XtromAI/Airsoft-Display/docs/hardware/datasheets/README.md

# Datasheet Drop Folder

This directory is reserved for third-party datasheets, reference manuals, or vendor utilities that should **not** be committed to the public repository. The files you place here are ignored by Git so you can keep local copies without redistributing copyrighted material.

## Recommended Downloads

| Component / Resource | Official Source |
| --- | --- |
| Raspberry Pi Pico Datasheet | https://datasheets.raspberrypi.com/pico/pico-datasheet.pdf |
| Getting Started with Raspberry Pi Pico | https://datasheets.raspberrypi.com/pico/getting-started-with-pico.pdf |
| Raspberry Pi Pico Pinout (PNG) | https://datasheets.raspberrypi.com/pico/pico-pinout.png |
| Raspberry Pi "flash nuke" UF2 | https://datasheets.raspberrypi.com/soft/pico-bootrom/flash_nuke.uf2 |
| SH1107 OLED Controller Datasheet | https://www.displayfuture.com/Display/datasheet/controller/SH1107.pdf |
| ST L7805CV Regulator Datasheet | https://www.st.com/resource/en/datasheet/l7805.pdf |

Place any downloaded copies directly in this folder for your own reference. If new documentation is required, update this table instead of adding the actual files to version control.
