XtromAI/Airsoft-Display/docs/hardware/Airsoft Display circuit _251127_172856_1.jpg

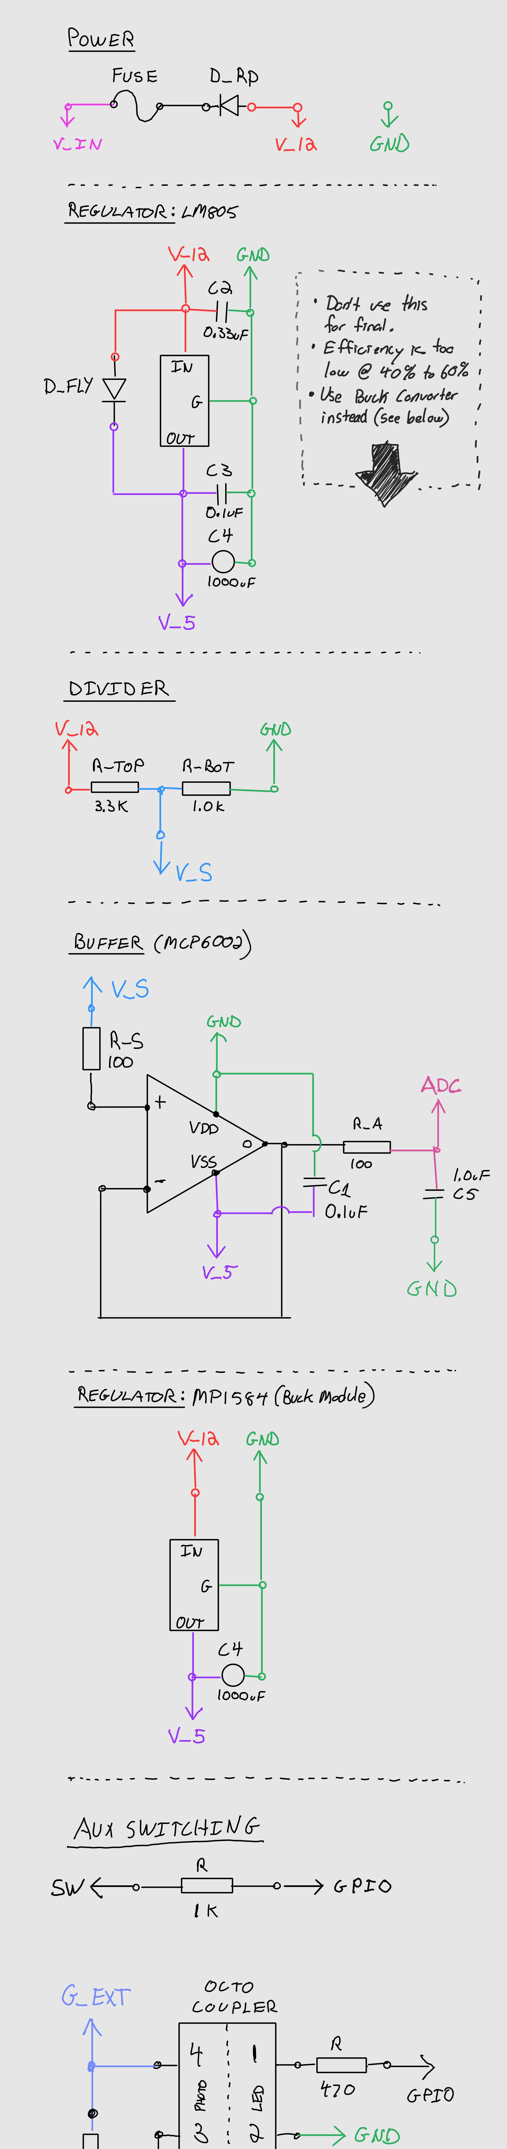
docs/hardware/Airsoft Display circuit _251127_172856_1.jpg
