XtromAI/Airsoft-Display/docs/hardware/airsoft-display-schematic.png

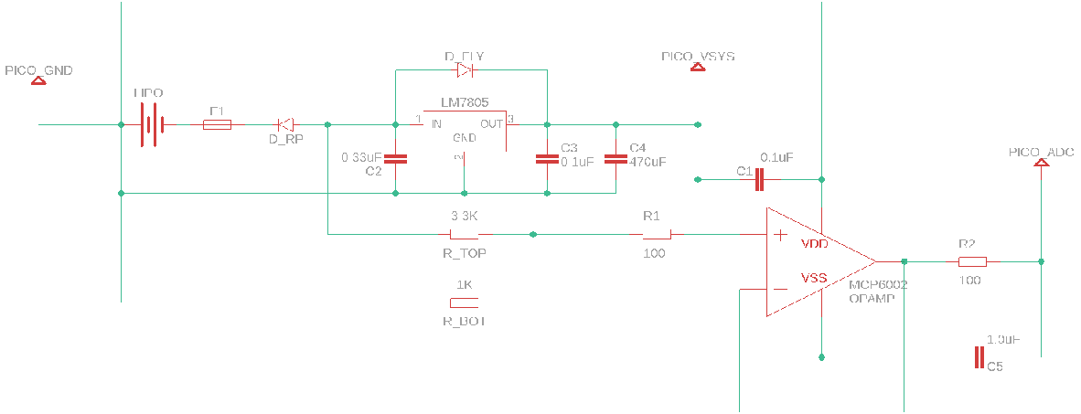
docs/hardware/airsoft-display-schematic.png
