XtromAI/Airsoft-Display/tools/data/capture_2025-11-11-22-56-46_a/capture_00000.png

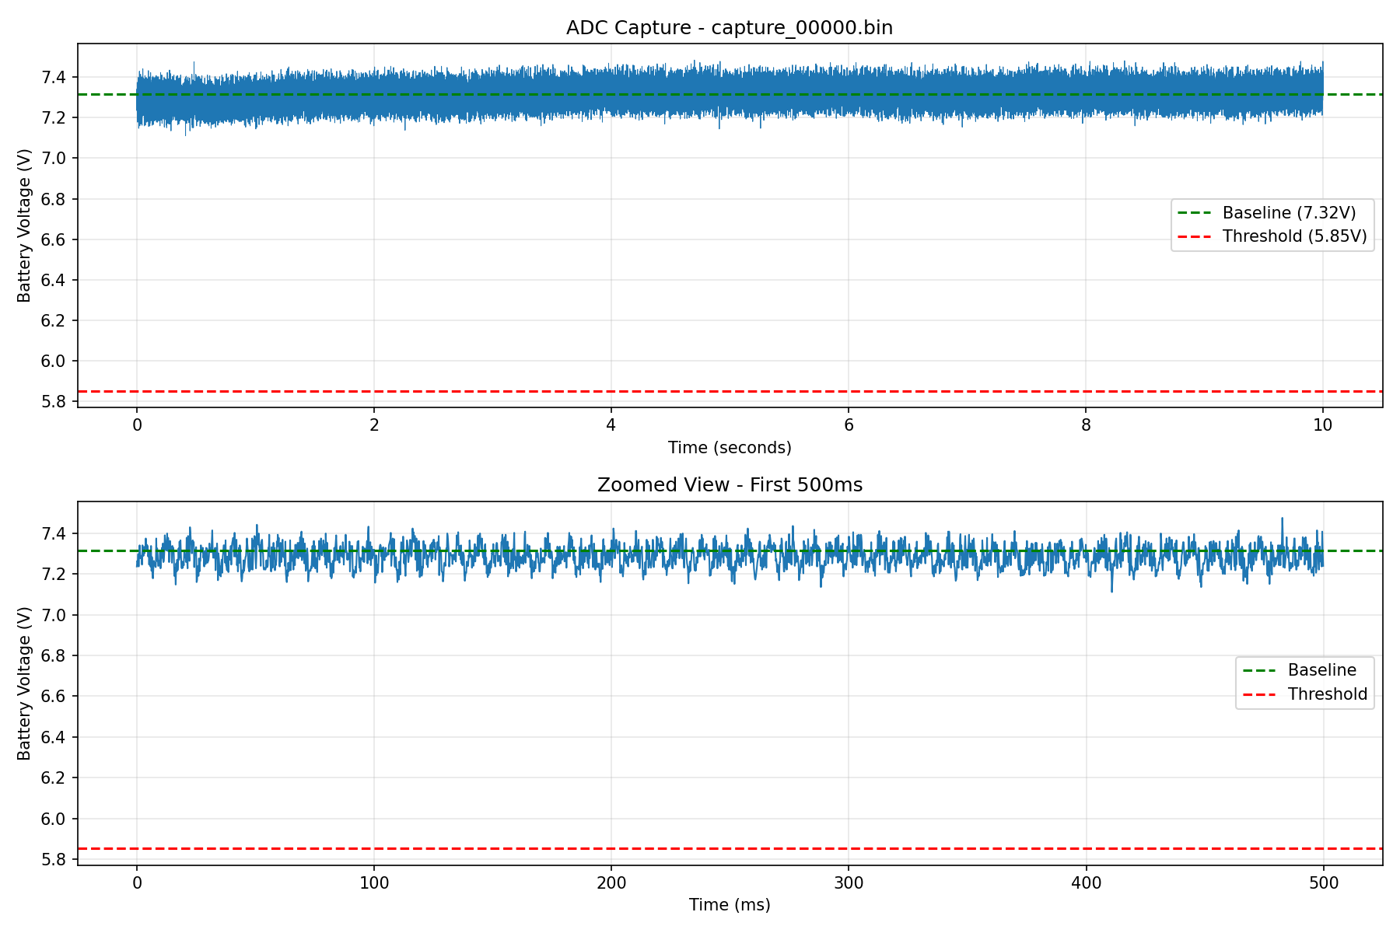
tools/data/capture_2025-11-11-22-56-46_a/capture_00000.png
