XtromAI/Airsoft-Display/tools/data/capture_2025-11-11-22-56-46_b/capture_00002.png

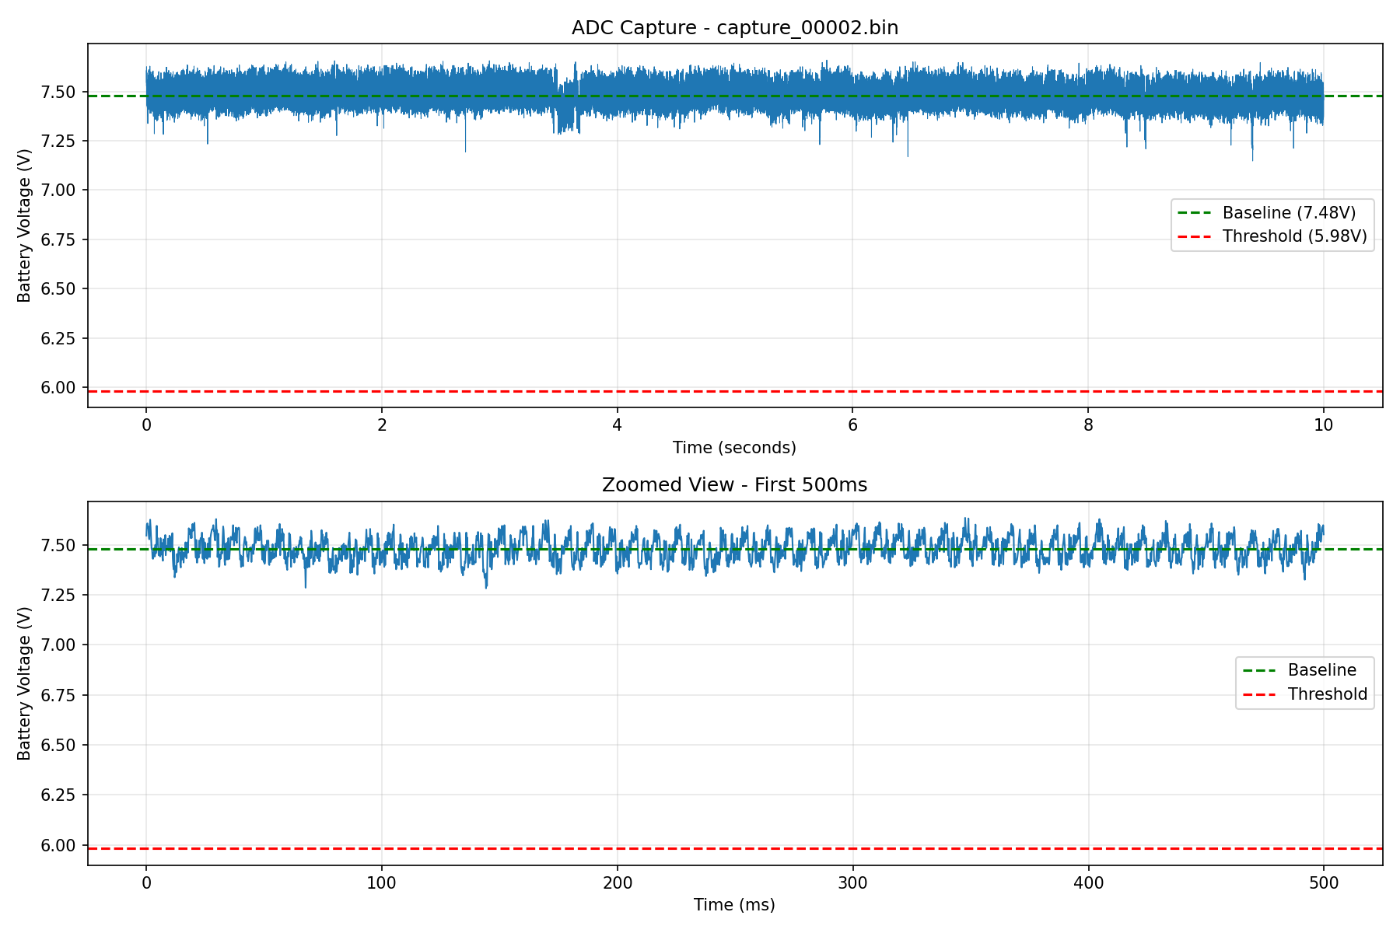
tools/data/capture_2025-11-11-22-56-46_b/capture_00002.png
