XtromAI/Airsoft-Display/tools/data/capture_2025-11-11-22-56-46_c/capture_00002_82096ms.png

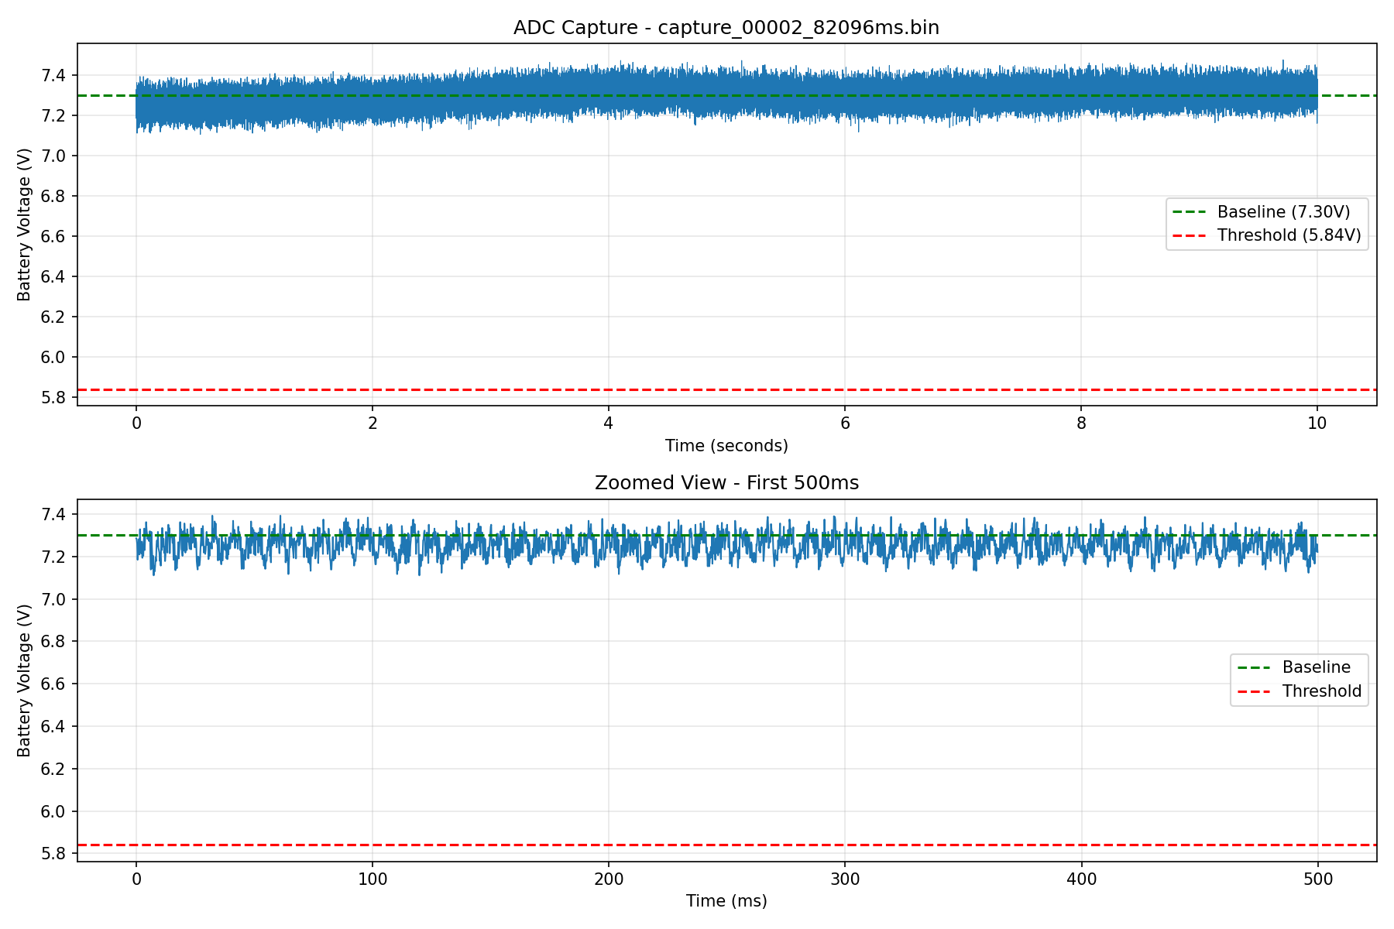
tools/data/capture_2025-11-11-22-56-46_c/capture_00002_82096ms.png
