XtromAI/Airsoft-Display/tools/data/capture_2025-11-20-19-31-21/capture_slot0_frequency_analysis.png

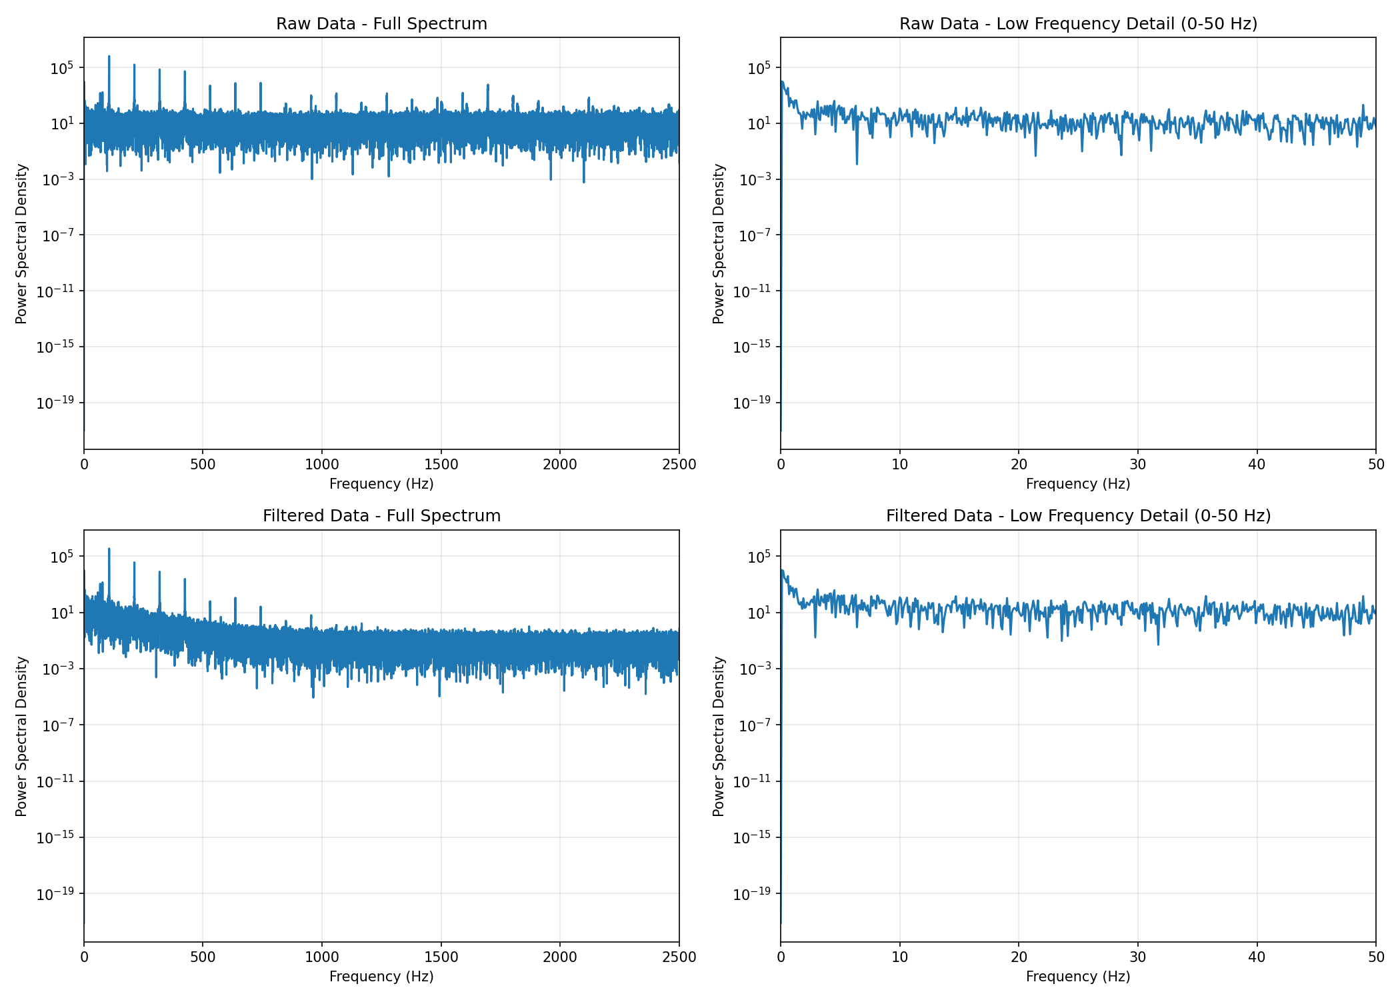
tools/data/capture_2025-11-20-19-31-21/capture_slot0_frequency_analysis.png
