XtromAI/Airsoft-Display/tools/data/capture_2025-11-20-19-31-21/capture_slot0_low_freq_analysis.png

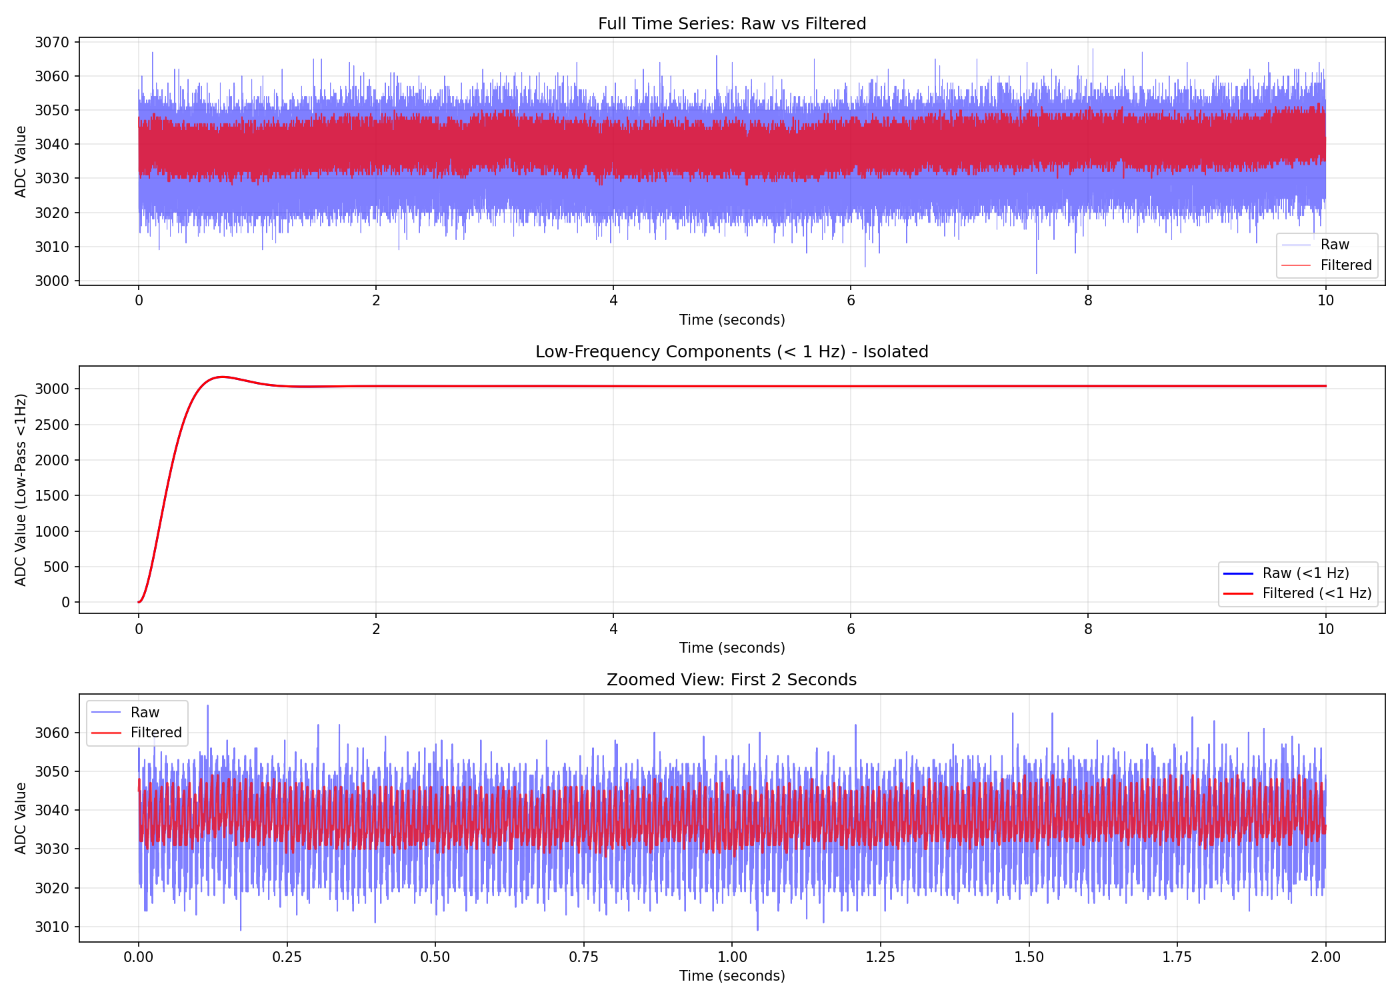
tools/data/capture_2025-11-20-19-31-21/capture_slot0_low_freq_analysis.png
