XtromAI/Airsoft-Display/docs/devlog/2025-10-31-RECONNECTION-GUIDE.md

# Airsoft Display Project - Quick Reconnection Guide

## What You've Built So Far

You've made excellent progress! Here's the state of your Airsoft shot counter and battery monitor:

### 🎉 Major Accomplishments

**1. Custom Display Driver (Instead of U8g2)**
- Built a complete SH1107 display driver from scratch (`lib/sh1107-pico/`)
- Full graphics primitives: lines, rectangles, circles, triangles
- Custom 8x8 and 16x16 bitmap fonts
- Smooth 60Hz display updates

**2. Solid Architecture**
- Dual-core design working: Core 0 (display) + Core 1 (data acquisition)
- Mutex-protected data sharing between cores
- Watchdog timer for crash recovery
- Temperature monitoring system

**3. Foundation for ADC Sampling**
- `ADCSampler` class implemented with timer-based approach
- Currently running at 10Hz (testing rate)
- Ready to upgrade to DMA-based high-frequency sampling

## What's Left to Build (The Fun Part!)

### Critical Path to Working Product

**Step 1: High-Speed ADC Sampling** (Most Important)
- Replace timer-based sampling with DMA circular buffer
- Target: 1000+ samples per second
- This is the foundation for shot detection
- Files to modify: `lib/adc_sampler.cpp`, `src/main.cpp`

**Step 2: Shot Detection Algorithm**
- Calculate moving average from ADC samples
- Detect voltage dips (shots cause battery voltage to drop briefly)
- Increment shot counter when dip exceeds threshold
- Files to modify: `src/main.cpp`

**Step 3: Button Input**
- Implement button handling on GP9/GP10
- Long press (3 seconds) to reset shot counter
- Files to modify: `src/main.cpp`

**Step 4: Display the Goods**
- Show shot count in large text
- Show battery voltage with proper conversion
- Optional: Add voltage graph showing recent history

### Why This Order?

1. **ADC first** - Can't detect shots without high-speed voltage sampling
2. **Detection second** - Core feature, makes the device useful
3. **Button third** - User interaction to reset counter
4. **Display last** - Polish and user experience

## Code Organization

```
Your main files to work with:
├── src/main.cpp              # Core 0 & 1 logic - where most work happens
├── lib/adc_sampler.cpp/.h    # Upgrade this to DMA-based sampling
├── lib/sh1107-pico/src/      # Display driver (pretty much done!)
└── docs/planning/2025-10-31-PROJECT-STATUS.md    # Detailed status tracking
```

## Quick Development Loop

```bash
# 1. Make your changes in VS Code

# 2. Compile (don't run "Run Project" task - per instructions)
# Use "Compile Project" task or:
ninja -C build

# 3. Flash to device
# Use "Flash" task

# 4. Debug via display (no serial output currently)
```

## Documentation Cleanup Completed

I've cleaned up your docs:

✅ **Removed:**
- `display-driver-research.md` - U8g2 research (not used)
- `display-library-comparison.md` - Library comparison (decision made)

✅ **Updated:**
- `2025-01-15-design-guide.md` - Added note pointing to current status
- `2025-08-06-sh1107-update-plan.md` - Marked as future optimizations
- `2025-08-07-display-update-timing.md` - Noted current implementation
- `2025-08-06-sh1107-efficiency.md` - Marked as reference document

✅ **Created:**
- `2025-10-31-PROJECT-STATUS.md` - Comprehensive current state
- `2025-10-31-RECONNECTION-GUIDE.md` - This file (quick overview)

## Your Custom Display Driver Decision

**The Real Story (from git history):**

August 2025 - You spent a day trying to integrate U8g2 library:
1. Integrated U8g2 and tried to get it working
2. Only got static/noise on the display despite extensive troubleshooting
3. Created 400+ lines of research documentation
4. Commit message: *"tried all research and still display noise only, trying adafruit next"*
5. **24 minutes later:** *"got custom display driver working"* 

**What you did instead:**
- Found working MicroPython SH1107 driver (`sh1107.py`)
- Translated it to C++ in under half an hour
- Had a working display with full control

**Why this was brilliant:**
- U8g2's HAL callbacks were complex and something wasn't working
- Python reference code was proven and readable
- Custom driver = zero external dependencies
- You understand every line of code
- Optimized specifically for your SH1107 + Pico setup

**The archived evidence:**
See `docs/archive/` for the original U8g2 research docs - they're preserved as a reminder that sometimes the best solution is to write it yourself when libraries don't cooperate.

**Trade-off:**
- More code to maintain, but it's YOUR code and it WORKS

## What Makes This Project Cool

1. **Dual-core optimization** - Leveraging RP2040's strengths
2. **Custom driver** - Not just using off-the-shelf libraries
3. **Real-world application** - Actual hardware problem solving
4. **Performance focus** - DMA, high-speed sampling, optimized display

## Next Session Recommendations

**If you have 30 minutes:**
- Read through `src/main.cpp` to refresh on the code structure
- Review the ADC sampler implementation

**If you have 1-2 hours:**
- Start implementing DMA-based ADC sampling
- Test with oscilloscope or serial output to verify sampling rate

**If you have a full day:**
- Complete DMA sampling
- Implement basic shot detection
- Get first working prototype!

## Resources in Your Docs

- `docs/planning/2025-01-15-design-guide.md` - Original specification
- `docs/planning/2025-10-31-PROJECT-STATUS.md` - Detailed current state
- `docs/display/` - Display-specific references
- `lib/sh1107-pico/docs/` - Your custom driver documentation

## Questions to Consider

1. **Voltage divider values?** Design guide mentions equal value resistors (10kΩ) for 2:1 division

> ⚠️ **Circuit Update Note:** This question is answered in the updated circuit design. The current circuit uses 3.3kΩ (R_TOP) and 1kΩ (R_BOT) resistors for a scaling factor of ~0.233 (4.3:1 division ratio), with an MCP6002 op-amp buffer. See [circuit-description.md](../hardware/circuit-description.md) for the complete voltage scaling block design.

2. **Shot detection threshold?** How much voltage dip indicates a shot?
3. **Sample rate?** 1kHz might be too slow for detecting very short dips
4. **Battery type?** 11.1V 3S LiPo affects voltage scaling

---

**Bottom line:** You have a solid foundation. The display system works beautifully. Now it's time to implement the core detection logic to make it a functional shot counter!
