XtromAI/Airsoft-Display/(commit log)

2025-08-03 Add initial hardware design documentation for Raspberry Pi Pico shot counter and battery monitor project
2025-08-03 Refactor project structure: replace airsoft-display.cpp with main.cpp and add pico_examples.cpp
    [main.cpp]
2025-08-04 compiled blinking led
2025-08-04 Update main.cpp for SH1107 display: adjust pin assignments, improve SPI initialization, and add display test routines
2025-08-05 tried all research and still display noise only, trying adafruit next
    [main.cpp]
2025-08-05 got custom display driver working
2025-08-05 added sh1107 driver docs
2025-08-06 moved sh1107 driver to lib
2025-08-07 refactor SH1107 driver: reorganize methods and remove drawChar function
2025-08-07 refactor SH1107 driver: add font management and update drawString signature
2025-08-09 put display on hardware timer
2025-08-09 increase refresh to 60hz
2025-08-10 refactor temperature handling: encapsulate ADC initialization and improve formatted temperature retrieval
2025-08-10 clean up: remove unnecessary blank lines in temperature header and source files
2025-08-10 feat: integrate temperature handling and display functionality
2025-08-10 feat: add getFontHeight method and simplify temperature display positioning
2025-08-10 feat: add support for temperature unit selection in Temperature class
2025-08-10 added adc 4 to each read
2025-08-12 Refactor/sh1107 (#14)
    * organized sh1107 functions
    * refactor SH1107 driver: replace magic numbers with named constants and improve initialization
    * Add documentation for display update timing and SH1107 driver efficiency
    - Created a new document on hardware timers and interrupts for display updates, emphasizing best practices for handling display updates in embedded systems.
    - Added recommendations for improving the efficiency of the SH1107 display driver, including partial updates, double buffering, SPI optimization, and power management strategies.
    * Update sh1107_driver.cpp with todo
    * Create sh1107-update-plan.md
2025-08-12 created adc sample code
2025-08-12 removed unused button code
2025-08-12 lower sample speed
2025-10-28 fixed serial debugging and locked core
    [main.cpp]
2025-10-29 Address feedback: correct voltage divider, add RP2040 hardware architecture details
2025-10-30 Apply code review feedback: correct L7805CV specs, clarify 10Hz limitation, improve constant naming guidance
2025-10-30 Remove all references to 7.4V LiPo batteries
2025-10-31 Implement DMA-based 5kHz ADC sampling with filter chain
2025-10-31 Add comprehensive DMA sampling implementation documentation
2025-10-31 Add quick start README for DMA sampling implementation
2025-10-31 Fix voltage divider configuration to match actual hardware (28kΩ + 10kΩ)
2025-10-31 Address code review feedback: fix race conditions, buffer tracking, and optimizations
    [main.cpp]
2025-10-31 Address second round of code review: fix initialization order, optimize voltage calc, clarify comments
    [main.cpp]
2025-10-31 Fix race condition in release_buffer() by disabling interrupts during critical section
2025-10-31 Use hw_set_bits for ADC trigger to follow SDK best practices
2025-10-31 Initialize ADC and clear stale samples in DMAADCSampler::init()
2025-10-31 Add DMA IRQ and timer trigger counters to DMAADCSampler and main display
2025-11-01 Add alarm pool for ADC timing and update timer handling in DMAADCSampler
2025-11-01 Refactor DMAADCSampler to use hardware alarms for ADC timing and remove alarm pool
2025-11-01 Add DMA status checks to main display and implement DMA busy state methods
2025-11-01 Refactor DMAADCSampler constructor and destructor for improved readability; update ADC conversion trigger logic to ensure readiness before sampling.
2025-11-01 Temporarily disable temperature sampling via ADC; update display to show placeholder for temperature readings and add TODO for future implementation.
2025-11-01 Remove temperature module and related references from the project
2025-11-01 Update project status and remove temperature module; implement DMA-based ADC sampling at 5 kHz
2025-11-01 Remove temperature module and related header files from the project
2025-11-03 remove old timer based adc code
2025-11-04 added adc investigation summary and simplified schematic
2025-11-04 added adc testing scripts and opamp buffer plans
2025-11-04 Create netlist for LM7805 and associated components
    Added netlist for LM7805 regulator, voltage divider, and op-amp buffer with detailed connections and components.
2025-11-05 added circuit design
2025-11-06 complete schematic
2025-11-06 updated circuit description
2025-11-06 Complete data collection implementation for 5kHz sampler
2025-11-06 high res schematic
2025-11-12 collected data
    [capture_00000.csv, capture_00002.csv, capture_00002_82096ms.csv]
2025-11-14 Data analysis confirms current 100 Hz software filter is optimal (#28)
    * Initial plan
    * Add data analysis tool for voltage sample analysis
    * Add comprehensive filtering analysis and recommendations document
    * Add data analysis summary README
    * Add top-level filtering analysis summary for quick reference
    ---------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
2025-11-14 Add filtered data collection alongside raw samples
2025-11-14 Add documentation for filtered data collection feature
2025-11-14 Add implementation summary for filtered data collection
2025-11-21 Add missing include for <new> in main.cpp
    [main.cpp]
2025-11-21 fixed flash storage slot size
2025-11-21 new dual capture, session summary
    [capture_slot0.csv]
2025-11-21 Add detailed filter improvement implementation plan
2025-11-27 Cleanup (#34)
    [capture_00000.csv, capture_00002.csv, capture_00002_82096ms.csv, capture_slot0.csv]
2025-11-27 Added updated schematics
2025-11-28 Update circuit description to match new schematic (#36)
    * Update circuit-description.md based on new schematic
    ---------
    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
2025-12-04 docs: Update circuit documentation with current design (#37)
    * docs: Add outdated circuit notes to documentation files
    * docs: Integrate circuit updates into README and copilot-instructions
    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
